ecaraszi/wsr/pcb/wsr2_schematic.pdf

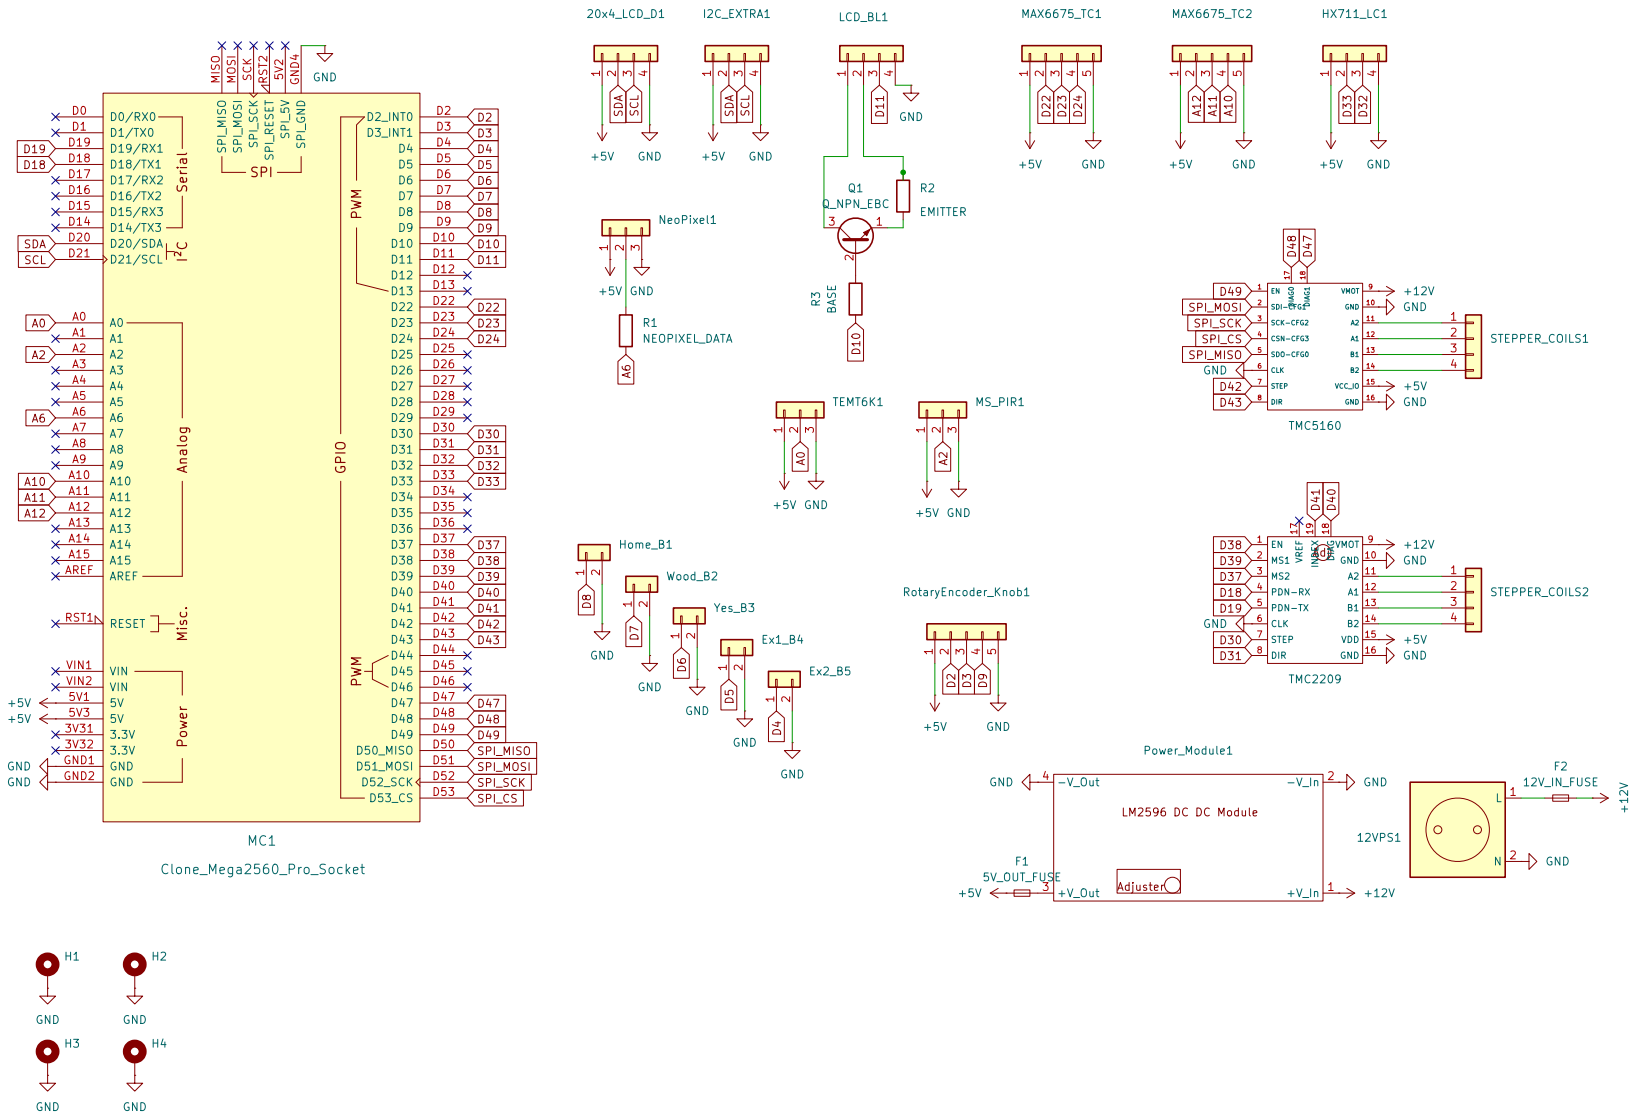
[picture p21: page 1]
