ecaraszi/wsr/pcb/wsr2_cu.pdf

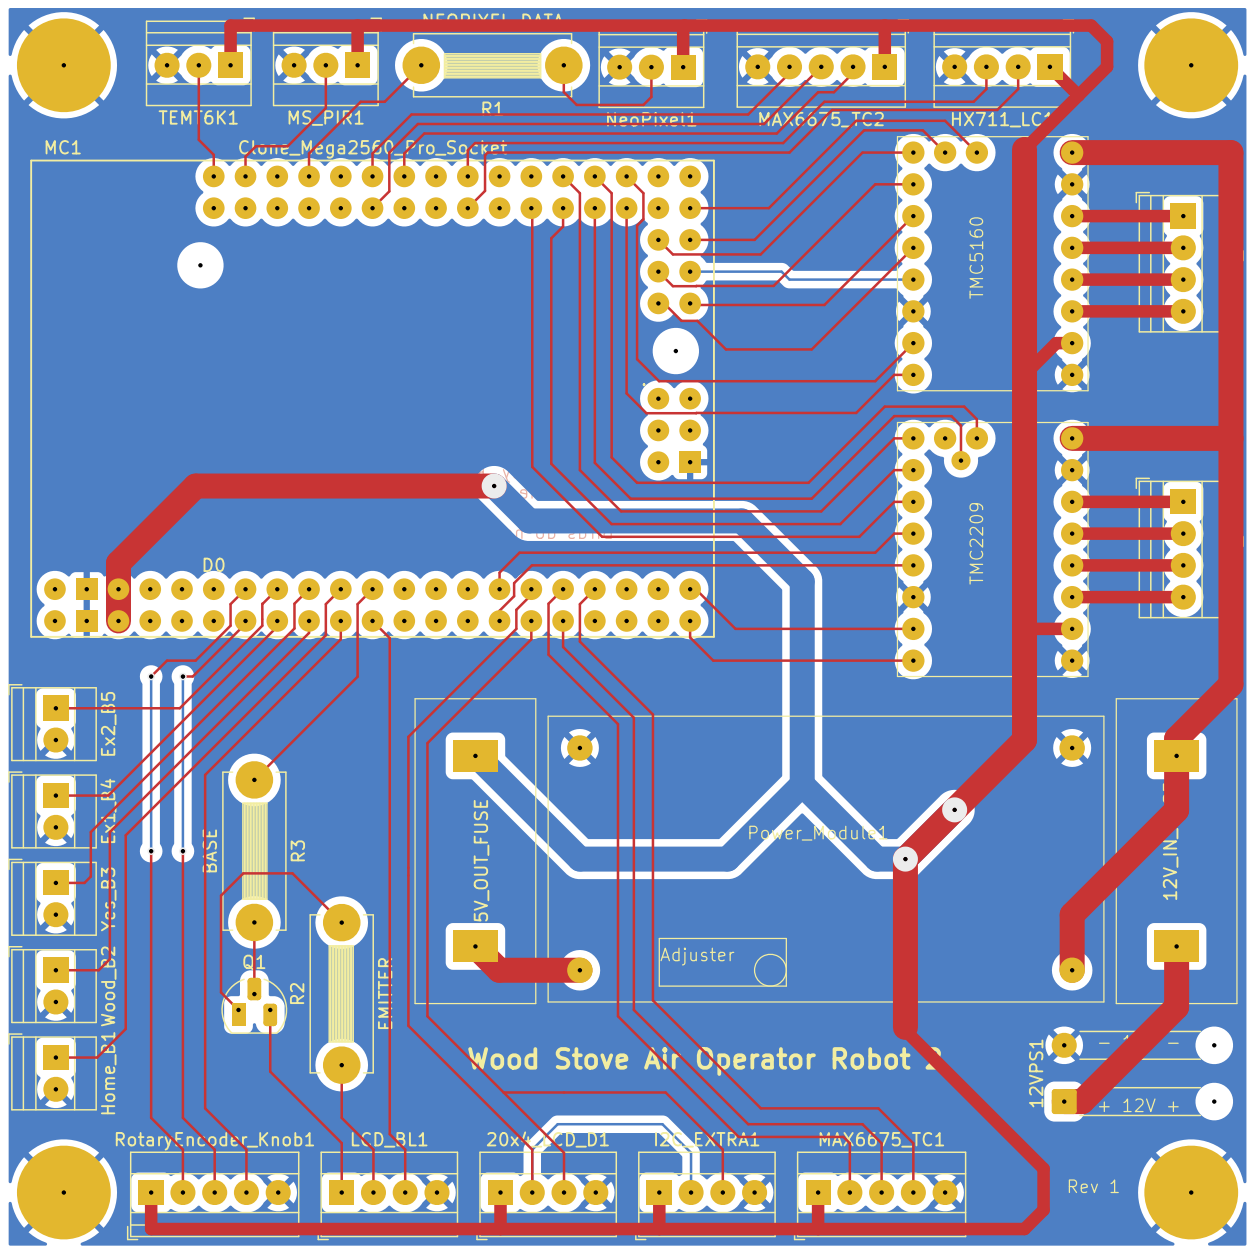
[picture p22: page 1]
