ecaraszi/wsr/pcb/wsr2_pcb.pdf

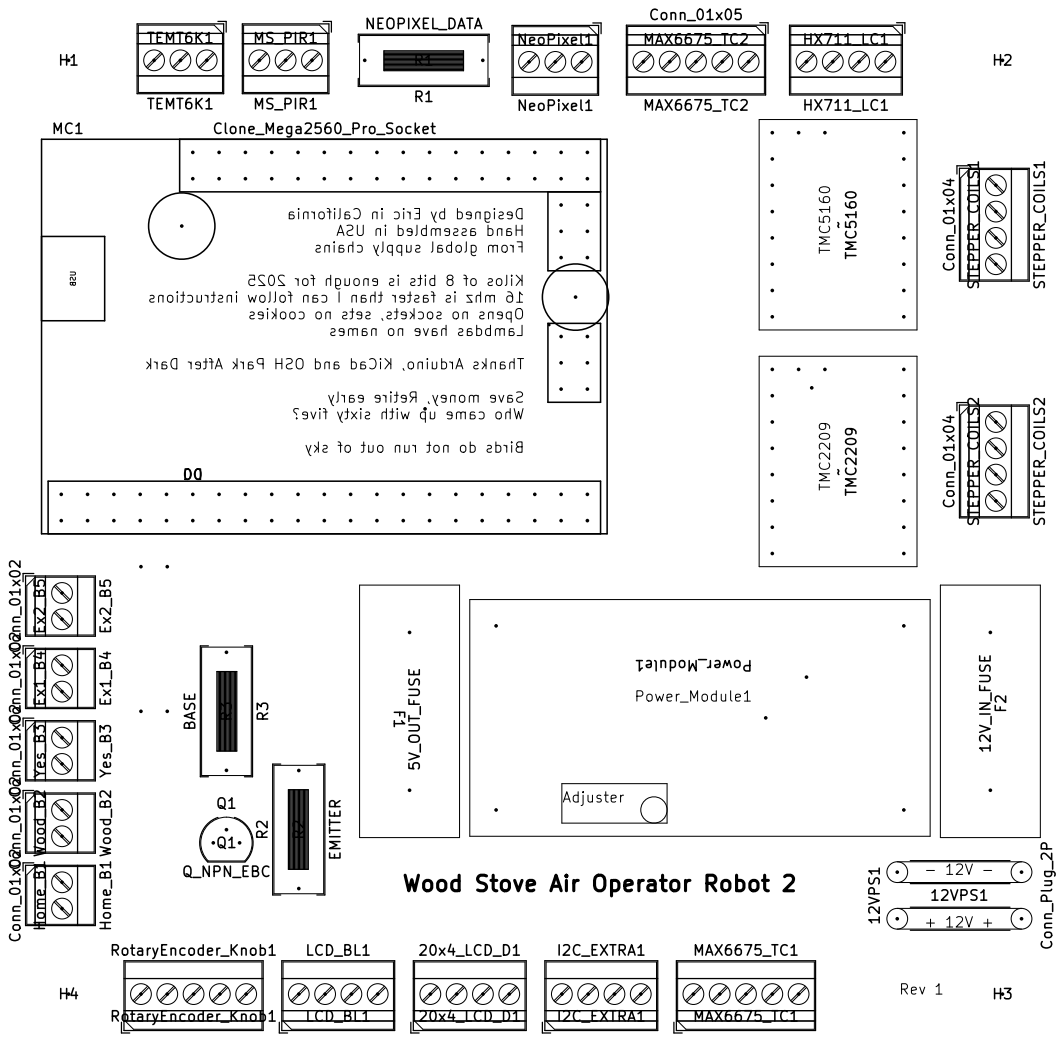
[picture p23: page 1]
